javirosa/tier-charge-controller/v4/Charge Controller V4.0 Pinout.png

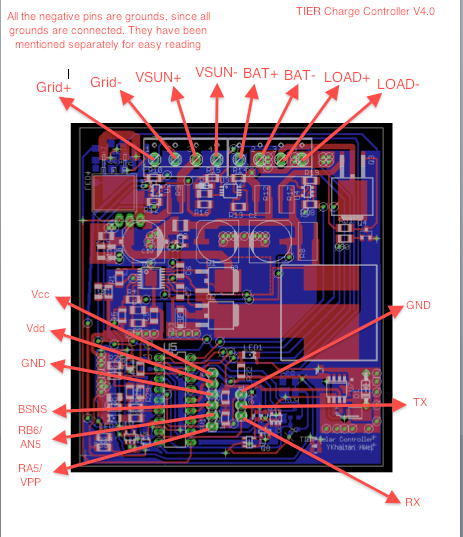
v4/Charge Controller V4.0 Pinout.png
