javirosa/tier-charge-controller/v4/bom.xls

Partl | ist
Expor | ted from | solar | _hv4_1.sch at 2/22/11 | 2:32:00
EAGLE | Version | 5.7.0 | Copyright (c) 1988-2 | 010 CadSo | ft
Part |  | Value | Device |  | Package
BRL32 | 25T101K |  | INDUCTOR1210 |  | 1210
C1 |  | 1n | C-USC1206 |  | C1206 | 0.0117
C2 |  | 220u | CPOL-USUD-10 | X10 | UD-10X10_NICHICON | 0.219
C3 |  | 68u | CAP0805 |  | 805 | 0.219
C4 |  | 100p | C-USC1206 |  | C1206 | 0.0117
C5 |  | 680p | C-USC1206 |  | C1206 | 0.0117
C6 |  | 1u | C-USC1206 |  | C1206 | 0.046
C7 |  | 1u | C-USC1206 |  | C1206 | 0.046
C8 |  | 10u | C-USC1210 |  | C1210 | 0.369
C9 |  | 220u | CPOL-USUD-10 | X10 | UD-10X10_NICHICON | 0.219
C10 |  | 1u | C-USC1206 |  | C1206 | 0.046
C11 |  | 1u | C-USC1206 |  | C1206 | 0.046
C12 |  | 1u | C-USC1206 |  | C1206 | 0.046
C13 |  | 100u | CPOL-USG |  | PANASONIC_G | 0.219
C14 |  | 0.1u | C-USC1206 |  | C1206 | 0.0117
C16 |  | 1u | C-USC1206 |  | C1206 | 0.046
C19 |  |  | CAP0805 |  | 805 | 0.369
C20 |  |  | CAP0805 |  | 805 | 0.369
C21 |  | 120u | CAP0805 |  | 805 | 0.219
C22 |  |  | CAP0805 |  | 805 | 0.369
C23 |  |  | CAP0805 |  | 805 | 0.369
D1 |  | 1N5817 | -T 1N5817-T |  | DO41-7.6 | 0.42
D2 |  | BAS19 | BAS19 |  | SOT23 | 0.32
D3 |  | SS14 | SS14 |  | SMA | 0.58
D4 |  | Z1.8V | DIODE-SOD123 |  | SOD123 | 0.6
D5 |  | UHB10F | T-E3/4W BY229B |  | TO263AB | 1.41
DB1 |  | BAS400 | 2A-RPP BAS4002A-RPP |  | SOT143-R | 0.54
L1 |  | B82559 | B82559 |  | L23X25MM | 17.39
LED1 |  |  | 475-14 16-1-ND LEDCHIPLED_1 | 206 | CHIPLED_1206 | 0.11
LED2 |  |  | 16-1-ND LEDCHIPLED_1 | 206 | CHIPLED_1206 | 0.11
LED3 |  |  | 16-1-ND LEDCHIPLED_1 | 206 | CHIPLED_1206 | 0.11
LED4 |  |  | 16-1-ND LEDCHIPLED_1 | 206 | CHIPLED_1206 | 0.11
Q1 |  |  | IRFR1018 |  | TO252 | 2.3
Q2 |  |  | IRFR1018 |  | TO252 | 2.3
Q3 |  |  | SPB80P06P |  | TO263 | 3.95
Q4 |  |  | BC850SMD |  | SOT23-BEC | 0.38
Q5 |  |  | BSS84TA |  | SOT-23 | 0.58
Q6 |  |  | BSS84TA |  | SOT-23 | 0.58
Q7 |  |  | BSS84TA |  | SOT-23 | 0.58
Q8 |  |  | BSS84TA |  | SOT-23 | 0.58
Q9 |  |  | 2SJ412(Q) |  | TO-220 | 3.37
R1 |  | 1M | R-US_R1206 |  | R1206 | 0.01
R2 |  | 140k | R-US_R1206 |  | R1206 | 0.01
R4 |  | 174k | R-US_R1206 |  | R1206 | 0.01
R5 |  | 20k | R-US_R1206 |  | R1206 | 0.01
R6 |  | 5m | FCSLXXRXXXFC | SL64R005 | FCSL64-5M | 0.4
R7 |  | 82.5k | R-US_R1206 |  | R1206 | 0.01
R8 |  | 10m | FCSLXXRXXXFC | SL90R010 | FCSL90-10M | 0.4
R9 |  | 5m | FCSLXXRXXXFC | SL64R005 | FCSL64-5M | 0.01
R10 |  | 3.3k | R-US_R1206 |  | R1206 | 0.01
R11 |  | 100 | R-US_R1206 |  | R1206 | 0.01
R12 |  | 5m | FCSLXXRXXXFC | SL64R005 | FCSL64-5M | 0.01
R13 |  | 100 | R-US_R1206 |  | R1206 | 0.01
R14 |  | 100 | R-US_R1206 |  | R1206 | 0.01
R15 |  | 1.6k | R-US_R1206 |  | R1206 | 0.01
R16 |  | 1.6k | R-US_R1206 |  | R1206 | 0.01
R17 |  | 5m | FCSLXXRXXXFC | SL64R005 | FCSL64-5M | 0.4
R18 |  | 3.3k | R-US_R1206 |  | R1206 | 0.01
R19 |  | 100 | R-US_R1206 |  | R1206 | 0.01
R20 |  | 90.9k | R-US_R1206 |  | R1206 | 0.01
R21 |  | 10k | R-US_R1206 |  | R1206 | 0.01
R22 |  | 90.9k | R-US_R1206 |  | R1206 | 0.01
R23 |  | 10k | R-US_R1206 |  | R1206 | 0.01
R24 |  | 90.9k | R-US_R1206 |  | R1206 | 0.01
R25 |  | 10k | R-US_R1206 |  | R1206 | 0.01
R26 |  | 680 | R-US_R1206 |  | R1206 | 0.01
R27 |  | 240 | R-US_R1206 |  | R1206 | 0.01
R28 |  | 60k | R-US_R1206 |  | R1206 | 0.01
R29 |  | 18k | R-US_R1206 |  | R1206 | 0.01
R30 |  | 8.2k | R-US_R1206 |  | R1206 | 0.01
R31 |  | 82k | R-US_R1206 |  | R1206 | 0.01
R32 |  | 1k | R-US_R1206 |  | R1206 | 0.01
R33 |  | 1k | R-US_R1206 |  | R1206 | 0.01
R34 |  | 3.3k | R-US_R1206 |  | R1206 | 0.01
R35 |  | 100 | R-US_R1206 |  | R1206 | 0.01
R36 |  | 90.9k | R-US_R1206 |  | R1206 | 0.01
R37 |  | 10k | R-US_R1206 |  | R1206 | 0.01
R38 |  | TBD | R-US_R1206 |  | R1206 | 0.01
R39 |  | TBD | R-US_R1206 |  | R1206 | 0.01
R40 |  | 1k | R-US_R1206 |  | R1206 | 0.01
R41 |  | 1k | R-US_R1206 |  | R1206 | 0.01
SV1 |  |  | MA06-1 |  | MA06-1 | 0.61
SV2 |  |  | MA03-1 |  | MA03-1 | 0.32
U1 |  |  | LT3800 |  | TSSOP16 | 8.08
U2 |  |  | LT6101 |  | TSOT-23-5 | 4.03
U3 |  |  | LTC1604 |  | MSOP8 | 1.97
U4 |  |  | LT6101 |  | TSOT-23-5 | 4.03
U5 |  |  | PIC16F87/88 |  | DIL18 | 4
U7 |  |  | LM2594M-3.3 |  | 8-SOIC | 3.42
U8 |  |  | LT6101 |  | TSOT-23-5 | 4.03
U9 |  |  | MIC842 |  | SC70-5 | 1.26
U10 |  |  | NC7S04M5X |  | SOT23-5 | 0.5
U11 |  |  | NC7S04M5X |  | SOT23-5 | 0.5
U12 |  |  | TMP35 |  | SOT23-5 | 1.35
X1 |  |  | W237-4 |  | W237-4 | 0.4
X2 |  |  | W237-4 |  | W237-4 | 0.4
 |  |  |  |  | Total | 76.05
